NischalSehrawat/Self-Balancing-Segway-Robot/Trials/Balancing_bot.py

# -*- coding: utf-8 -*-
"""
Created on Sun May 20 21:27:48 2018

@author: Nischal
"""

import serial 
from datetime import datetime
import time
from numpy import array, zeros, mean, random
from My_PID import PID

cont = PID(Kp = 0, Kd = 0 , Ki = 0, 
           SetPoint = 0, SampleTime = 200, OutMin = 30, OutMax = 255, mode = "Auto") # Initialise controller

arduino = serial.Serial('COM3', baudrate = 115200) # Initialise arduino serial


for i in reversed(range(5)):
    
    print("I am going the start the system in "+(str(i))+ "[sec]" )
    
    time.sleep(0.5)

	
while 1:
    
    data = cont.get_serial_data(arduino)
            
    if data is not None: #If arduino returned reliable data, then do the computing
        
        Kp, Kd, Ki, Theta_x = data
                
        print(" \n Arduino sent Kp = ", Kp , "Kd = ",Kd , "Ki = ", Ki, "Theta_x = ", Theta_x)
        
        cont.set_tunings(Kp, Kd, 0) # Update new PID parameters
        
        Output_scaled = cont.Compute_PID_Output(Input = Theta_x) # Compute the output of PID Algorithm
        
        if Output_scaled is not None: # If the PID sample time was exceeded only then the output is not None, else the output is None 
            
            ff = "<"+str(Output_scaled)+','+str(cont.error)+">" #  Wrap the processed data around delimiters so it can be parsed by Arduino
               
            arduino.write(ff.encode()) # Send the data to Arduino
            
            print("\n Pi Sent = ", Output_scaled, "Error = ", cont.error)
                                    
                
arduino.close()
