NischalSehrawat/Self-Balancing-Segway-Robot/Computer_Vision/For_Color_Tracking.py

# import the necessary packages
import numpy as np
from picamera.array import PiRGBArray
from picamera import PiCamera
import time
import cv2
 
# initialize the camera and grab a reference to the raw camera capture
camera = PiCamera()
camera.resolution = (512, 512)
camera.framerate = 32
rawCapture = PiRGBArray(camera, size=(512, 512))
 
# allow the camera to warmup
time.sleep(0.1)
 
# capture frames from the camera
for frame in camera.capture_continuous(rawCapture, format="bgr", use_video_port=True):
	# grab the raw NumPy array representing the image, then initialize the timestamp
	# and occupied/unoccupied text
	image = frame.array
	hsv = cv2.cvtColor(image, cv2.COLOR_BGR2HSV)
	low = np.array([100,50,50])
	high = np.array([140,255,255])

	image_mask = cv2.inRange(hsv,low,high)

	output = cv2.bitwise_and(image, image, mask = image_mask)

 
	# show the frame
	cv2.imshow("Frame", output)
	key = cv2.waitKey(1) & 0xFF
 
	# clear the stream in preparation for the next frame
	rawCapture.truncate(0)
 
	# if the `q` key was pressed, break from the loop
	if key == ord("q"):
            break
