NischalSehrawat/Self-Balancing-Segway-Robot/(commit log)

2018-05-21 Corrected error as mode was not declared while initialising PID class
    Corrected error as mode was not declared while initialising PID class
2018-05-21 Corrected the spelling of Intergral to "Integral"
    Corrected the spelling of Intergral to "Integral"
    [Balancing_bot.py]
2018-05-21 Added condition to check serial port data
    Added condition to check that if the data coming from serial port is not float, skip it
    [Balancing_bot.py]
2018-05-21 Checked errors in Serial data
    Added conditions to if the Serial data is parsable and convertible to float
    [Balancing_bot.py]
2018-05-22 Inserted new condition with <> data packets
    Packed the incoming data in <>
2018-05-22 Added condition for PID sampling time non exceedence
    Added code for the condition of the PID sampling time didn't exceed
    [Balancing_bot.py]
2018-05-23 Wrapped Output data around delimiters for easy parsing by Arduino
    Made necessary changes to send data to Arduino
2018-05-23 Added Arduino file that sends and recieves data with Python / Rpi
    Added Arduino file that sends and recieves data with Python / Rpi
2018-05-24 Removed PID library
    Removed PID library as I am using my own library on the PI
2018-05-30 Complete bot on Rpi
    Complete robot will be made on Rpi, only for PID tuning, analogue input from the potentiometers will be read from the Arduino.
2018-05-30 Defined new range for PID output as per PWM
    Defined new range for PID output as per PWM
2018-05-30 Corrected changes
    Corrected changes
    [Balancing_bot.py]
2018-05-30 Corrected output range as per Rpi PWM
    Corrected output range as per Rpi PWM
    [Bal_bot_Pi.py]
2018-05-30 Imported distance sensor as well
    Imported distance sensor as well
2018-05-31 Placed pin numbers with their variable names
    Placed pin numbers with their variable names
2018-07-16 Added code for motor RPM and MPU6050 data
    Added new classes for calcuating angles and motor RPM
2018-07-20 Corrected mistake in RPM smoothing
    Corrected mistake in RPM smoothing, set new limits, implemented a loop time, implemented plotting of recorded encoder / rpm data
    [Bal_bot_Pi.py]
2018-07-21 Added J_wh
    Added moment of inertia of the wheel
2018-07-21 This script calculates J_wheels from measured data
    This script calculates mass moment of inertia of the wheel and gears analysing data obtained by dropping a weight tried using a string from the wheels.
2018-07-30 Have to make this correction
    Have to make this correction
    [Bal_bot_Pi.py]
2018-07-30 Corrected Omega_X calculation
    Corrected Omega_X calculation
    [Bal_bot_Pi.py]
2018-07-30 Correcetd comment
    Corrected comment
    [Bal_bot_Pi.py]
2018-08-02 Corrected MPU caliberation terms
    Corrected MPU caliberation terms
    [Bal_bot_Pi.py]
2018-08-03 Corrected errors in MPU calculations
    Corrected errors in MPU calculations
    [Bal_bot_Pi.py]
2018-08-03 Kalman Filter
    Kalman filter
2018-08-03 Changed function name for complimentary filter
    Changed function name for complimentary filter
2018-08-03 Corrected caliberation error
    Corrected caliberation error
    [Bal_bot_Pi.py]
2018-08-03 Corrected name
    Corrected name
    [Bal_bot_Pi.py]
2018-08-03 Shifted complimetary and kalman filter classes to my classes
    Shifted complimetary and kalman filter classes to my classes
2018-08-03 Added unit converter to motor RPM class
    Added unit converter to motor RPM class
2018-08-04 Torque changed to Nm from Kg.cm
    Torque changed to Nm from Kg.cm
2018-08-05 Multiplied gear ratio and motor torque contant
    Multiplied gear ratio and motor torque contant
2018-08-05 Added code for Calculating scaled voltage
    Added code for Calculating scaled voltage
2018-08-05 Added np.abs value to the output else we will get error
    Added np.abs value to the output else we will get error
    [Bal_bot_Pi.py]
2018-08-05 Changed Torque to Voltage
    Changed Torque to Voltage
2018-08-06 Corrected motor resistance value to 7 ohm
    Corrected motor resistance value to 7 ohm
    [Bal_bot_Pi.py]
2018-10-14 Added Variable loop time PID class
    Added Variable loop time PID class
2018-10-14 Made changes to caliberation and PID loops
    Made changes to caliberation and PID loops
2018-10-17 Changed motor pin types to byte instead of int
    Changed motor pin types to byte instead of int
2018-10-24 My_Motor library to get RPM from encoder data
    My_Motor library to get RPM from encoder data
2019-01-06 Added Arduino Script and libraries
    Added Arduino Script and libraries
2019-01-07 Changed PID library to have variable loop time instead of fixed loop time
    Changed PID library to have variable loop time instead of fixed loop time
2019-01-09 Used encoder library to compute rotational wheel velocity
    Used encoder library to compute rotational wheel velocity
2019-01-10 changed int to short for motor pins
    changed int to short for motor pins
2019-01-10 Renamed encoder pins
    Renamed encoder pins
2019-01-10 Renamed motor and pins
    Renamed motor and pins
2019-01-13 Added Reset PID function
    Added Reset PID function
2019-01-13 Added blocking code for stopping motor and resting PID balance
    Added blocking code for stopping motor and resting PID balance
2019-01-14 Adjusted code for slowly increasing / decreasing the Translational velocity set point
    Adjusted code for slowly increasing / decreasing the Translational velocity set point
2019-01-14 Removed spaces and corrected closing brackets
    Removed spaces and corrected closing brackets
2019-03-05 Changed Kp_bal and Kd_bal and motor control direction
    Changed motor control direction and balancing parameters due to near gear box 1:30
2019-03-09 Commented out while(Wire.available() < 6) in get_MPU_data
    commented out because Wire.requestFrom() is blocking, so there is no point in waiting again
2019-03-09 Changed PPR to 330 due to upgraded gearbox
    Changed PPR to 330 due to upgraded gearbox
2019-03-09 Changed wheel radius to 130 mm
    Changed wheel radius to 130 mm
2019-03-09 Changed order of encoder pins because of the new gearbox
    Changed order of encoder pins because of the new gearbox
2019-03-10 Added correction factor for motor speed correction
    Added correction factor for motor speed correction
2019-03-11 Removed PID:: from the PID_V1.h file as it was giving error
    Removed PID:: from the PID_V1.h file as it was giving error
2019-03-26 Implemented speed control for both motors
    Implemented speed control for both motors
2019-03-26 Updated logid for resetting motor PID Iterms
    Updated logid for resetting motor PID Iterms
2019-03-26 Updated motor direction changing logic
    Updated motor direction changing logic
2019-03-26 Update Fresh_Bal_Bot.ino
    Updated lower and upper limit of balancing pid loop
2019-03-28 Corrected RPM calculation logic
    Corrected RPM calculation logic
    [My_Motors.cpp]
2019-03-28 Interchanged /renamed motor control logics
    Interchanged /renamed motor control logics as they were causing confusion because after the gearbox was changed, the direction of rotation got changed as well
2019-03-28 Deleted flowcharts
    Deleted flowcharts
2019-03-28 Introduced motor correction factor
    Introduced motor correction factor
2019-04-03 Updated new motor control function / logic to be tested
    Updated new motor control function / logic to be tested
2019-04-04 New motor control algorithm implemented
    New motor control algorithm implemented
2019-04-06 Updated a Kp_bal to 50, Removed PID for path correction
    Updated a Kp_bal to 50, Removed PID for path correction
2019-04-06 Added blink LED to Timer1 interrupt
    Added blink LED to Timer1 interrupt
2019-04-06 Tuned motor correction factor
    Tuned motor correction factor
2019-04-06 Updated Kp_bal value, added mode switch
    Updated Kp_bal value, added mode switch
2019-04-06 Added trans_controller switching
    Added trans_controller switching
2019-04-06 Colledted all boolean switching parameters at one place
    Colledted all boolean switching parameters at one place
2019-04-27 Working on speed difference between motors for driving straight
    Working on speed difference between motors for driving straight
2019-04-27 Corrected errors
    Corrected errors
    [My_Motors.h]
2019-04-28 Added logic for motor difference correction
    Added logic for motor difference correction
    [My_Motors.cpp, My_Motors.h]
2019-04-30 Removed encoder initialisers from Rotation if, added a new logic funtion for motor diff correction
    Removed encoder initialisers from Rotation if statement and shifted them to if (dt_mode_switch < 2000 || rotating == true){Setpoint_trans = 0.0; enc_init_hp = false; enc_init_mdc = false;}
    , added a new logic funtion for motor diff correction
2019-04-30 Removed long version of speed difference correction function
    Removed long version of speed difference correction function
    [Speed_Diff_Correction_LongFunction.ino]
2019-04-30 Removed print statements
    Removed print statements
2019-05-01 Added motor correction factor for the case when robot is in balance mode
    Added motor correction factor for the case when robot is in balance mode
    [Main_Code.ino]
2019-05-01 Added frequency domain decomposition for velocity
    Added frequency domain decomposition for velocity
2019-05-01 Removed speed difference PID controller logic from balancing code
    Removed speed difference PID controller logic from balancing code
2019-05-01 Changed Kp_trans to 8.0 in reset code
    Changed Kp_trans to 8.0 in reset code
    [Main_Code.ino]
2019-05-01 Removed redundant motor correction factor
    Removed redundant motor correction factor
    [Main_Code.ino]
2019-05-01 Corrected units of velocity in FFt
    Corrected units of velocity in FFt
2019-05-01 Corrected Spelling error
    Corrected Spelling error
    [Main_Code.ino]
2019-05-01 Changed motor correction factor
    Changed motor correction factor
    [Main_Code.ino]
2019-05-02 Replaced If else with Switch Case in ReadBt, also renamed the function
    Replaced If else with Switch Case in ReadBt, also renamed the function
    [Main_Code.ino]
2019-05-02 Replaced if-else statements with Switch Case in Bluetooth reading function
    Replaced if-else statements with Switch Case in Bluetooth reading function
    [Main_Code.ino]
2019-05-05 Transferref bluetooth wires from 0/1 to 10 and 11 as they were interfering with the script uploading
    Transferref bluetooth wires from 0/1 to 10 and 11 as they were interfering with the script uploading
    [Main_Code.ino]
2019-05-27 Changed Controller parameters, fixed typos
    Changed Controller parameters, fixed typos
    [Main_Code.ino]
